projetomoppe/sensor_node/(commit log)

2017-09-20 struct de dados definida
2017-09-20 apenas uma struct de dados
2017-10-04 sensor node finalizado
2017-10-20 Altecoes protitipo final
    novos pinos, led de status
2017-10-25 Update sensor_node.ino
    #define DEBUG
2017-10-27 adicionado sensor_node.ino final
2017-10-27 Imagens NRF24 e Módulo SD com capacitor
